ffosilva/bc-awake/openspec/changes/archive/2026-10-20-esp32cam-hardware-resilience-circuit/README.md

# esp32cam-hardware-resilience-circuit

Document and specify RC filtering and hardware resilience circuits for ESP32-CAM
