ffosilva/bc-awake/openspec/changes/esp32cam-prototype-pcb/README.md

# esp32cam-prototype-pcb

Create KiCad single-layer prototype carrier PCB for ESP32-CAM resilience circuit
