ffosilva/bc-awake/openspec/changes/archive/2026-10-10-captive-portal-inline-rename/README.md

# captive-portal-inline-rename

Replace window.prompt with inline row rename and formalize captive-portal UI resilience in setup-portal spec
