ffosilva/bc-awake/hardware/kicad/esp32cam-carrier/esp32cam-carrier.pdf

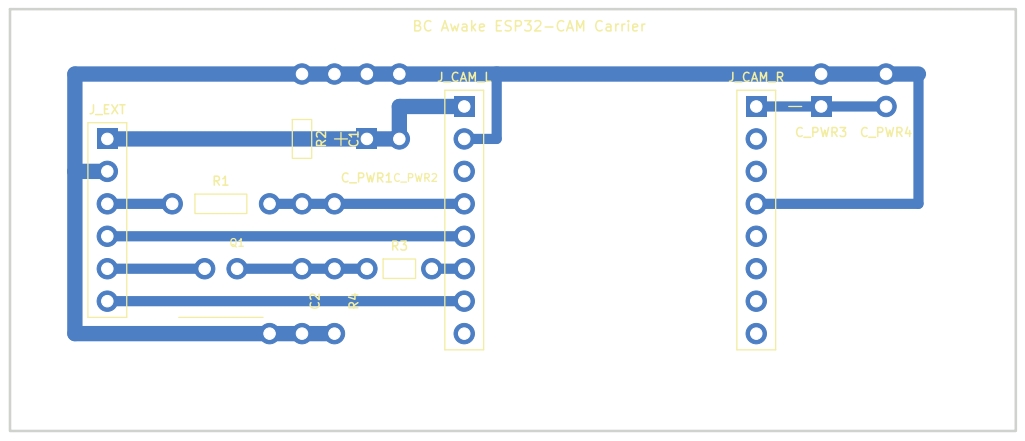
[picture p2: page 1]

BC Awake ESP32-CAM Carrier J_EXT
