ffosilva/bc-awake/hardware/kicad/esp32cam-carrier/esp32cam-carrier.kicad_pcb

## KiCad design hardware/kicad/esp32cam-carrier/esp32cam-carrier.kicad_pcb (2026-10-22)

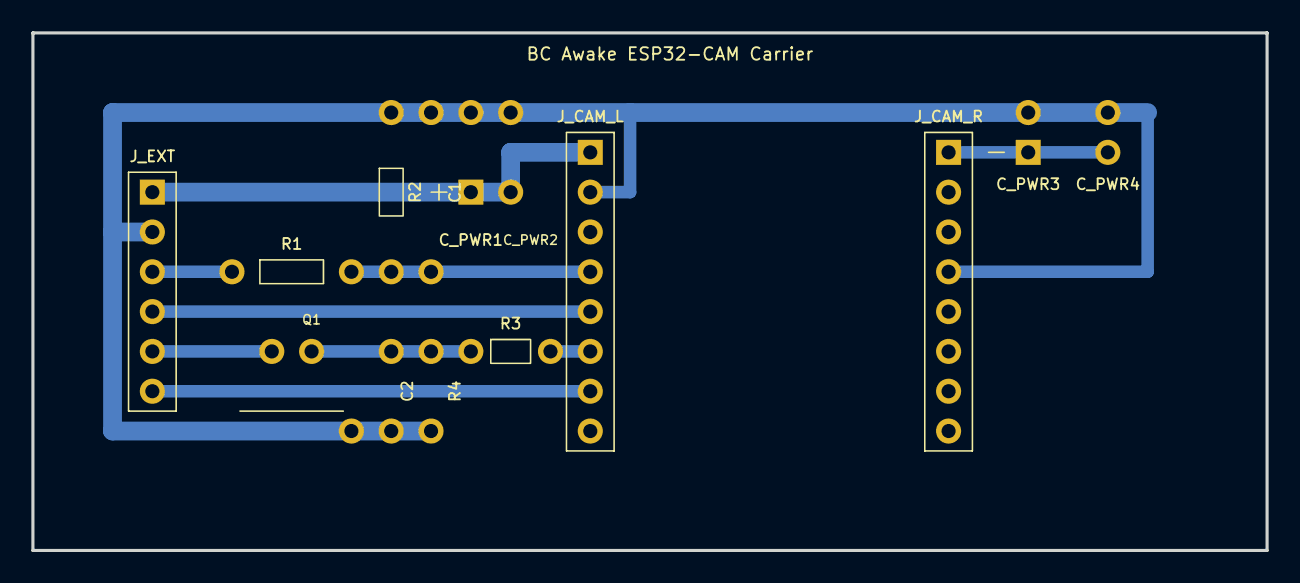
[picture p3: board esp32cam-carrier.kicad_pcb from above]

Board: 2 copper layers, 78.7 x 33.0 mm, 14 parts (0 on the bottom side), 10 nets.

Parts:
C1, C2: 100nF; C_Disc_D5.0mm_W2.5mm_P2.50mm
C_PWR1: 470uF; CP_Radial_D8.0mm_P3.50mm
C_PWR2, C_PWR4: 100nF; C_Disc_D5.0mm_W2.5mm_P2.50mm
C_PWR3: 47uF; CP_Radial_D6.3mm_P2.50mm
J_CAM_L: ESP32-CAM_L; PinSocket_1x08_P2.54mm_Vertical
J_CAM_R: ESP32-CAM_R; PinSocket_1x08_P2.54mm_Vertical
J_EXT: Ext_Terminals; PinHeader_1x06_P2.54mm_Vertical
Q1: BC547; TO-92_Inline
R1, R3: 1k; R_Axial_DIN0207_L6.3mm_D2.5mm_P7.62mm_Horizontal
R2: 4.7k; R_Axial_DIN0207_L6.3mm_D2.5mm_P7.62mm_Horizontal
R4: 100k; R_Axial_DIN0207_L6.3mm_D2.5mm_P7.62mm_Horizontal

Connections:
+3V3: C_PWR3.1, C_PWR4.1, J_CAM_R.1
+5VSB: C_PWR1.1, C_PWR2.1, J_CAM_L.1, J_EXT.1
BTN_A: J_CAM_L.5, J_EXT.4
GND: C1.1, C2.2, C_PWR1.2, C_PWR2.2, C_PWR3.2, C_PWR4.2, J_CAM_L.2, J_CAM_R.4, J_EXT.2, Q1.3, R2.1, R4.2
NET_GATE: C2.1, Q1.2, R3.1, R4.1
NET_IO13: C1.2, J_CAM_L.4, R1.2, R2.2
NET_IO14: J_CAM_L.6, R3.2
PS_ON#: J_EXT.5, Q1.1
PWR_BTN#: J_CAM_L.7, J_EXT.6
TPMS1: J_EXT.3, R1.1
