ffosilva/bc-awake/include/portal.h

#pragma once

#include <Arduino.h>
#include "board.h"

// Setup mode (SoftAP + discovery)
void portalBegin();
void portalLoop();
bool isPortalSetupMode();

// Normal mode persistent web server
void portalServerBegin();
void portalCheckRestart();

// Board state provider implemented by main.cpp
const char *getBoardStateName();

// Interactive pairing mode state
bool portalIsPairingActive();
void portalPairingStop();

// Wake cooldown arming implemented by main.cpp
void armWakeCooldown(unsigned long durationMs = WAKE_WAKE_COOLDOWN_MS);
