ffosilva/bc-awake/(commit log)

2026-10-10 fix(portal): replace window.prompt with inline controller rename editor
    Captive portal WebViews (such as Apple's CNA and Android's CaptivePortalLogin) suppress browser-native dialogs (window.prompt, window.alert), causing the controller rename button to silently do nothing when clicked.
    - Replace window.prompt with an inline row editor in app/index.html
    - Add keyboard support (Enter to save, Escape to cancel)
    - Display validation and network errors directly in the DOM
    - Formalize captive portal UI resilience in setup-portal spec
    - Archive OpenSpec change 2026-10-10-captive-portal-inline-rename
2026-10-13 feat(ota): add dual-bank ota update and firmware versioning
    - Reconfigure partition table with dual 1.81 MB OTA banks and 256 KB SPIFFS
    - Define compile-time semantic versioning and platform targets in include/version.h
    - Add authenticated POST /api/update streaming handler in setup portal with Update.h
    - Expose version and target in /api/status and display version badge in web UI
    - Add in-page firmware upload card to setup portal with progress bar
    - Update OpenSpec specifications and project documentation
    [partitions.csv]
2026-10-13 feat: add persistent setup portal, dynamic mac switching, and host sync
    Run the web server and REST API 24/7 over Wi-Fi Station with mDNS discovery, and dynamically switch Wi-Fi MAC between host dongle and ESP32 factory MAC across power states.
    - Enable persistent HTTP server on port 80 and mDNS advertising (bc250-switch.local) in normal Station mode
    - Implement dynamic Station MAC swapping: adopt host dongle MAC in STATE_OFF and revert to ESP32 factory MAC in STATE_BOOTING/STATE_ON
    - Add power-state aware API protections (403 on /api/network, 409 on /api/listener/start and /api/devices when powered on)
    - Expose boardState in /api/status and update web UI with status indicators and conditio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
    [main.cpp, network_wake.cpp, network_wake.h, portal.cpp, portal.h]
2026-10-13 feat: add configurable hostname and udp broadcast discovery
    Support custom device hostnames registered via DHCP and mDNS, and introduce an always-on UDP discovery responder on port 25025.
    - Add configurable hostname in NVS, DHCP (WiFi.setHostname), mDNS (MDNS.begin), REST API (/api/status, /api/network), and Web UI
    - Enforce RFC 1123 hostname validation (1–32 lowercase alphanumeric characters and hyphens)
    - Implement UDP broadcast discovery listener on port 25025 responding to BC250_DISCOVER with unicast JSON v1 across all power states
    - Add zero-config url=auto discovery mode to bc250-sync host tooling
    - Update OpenSpec specifications and archive configurable-hostname-and-discovery chang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
2026-10-13 feat(wake): inhibit power-on during controller pairing
    - Suppress controller and WOL wake triggers while pairing mode is active
    - Enforce 60s pairing timeout on firmware and add POST /api/listener/stop endpoint
    - Add non-blocking rapid flash LED burst (3 pulses) on ESP32-CAM upon listener start
    - Update setup portal UI with live 60s countdown, timeout screen, and post-save cooldown notice
    - Arm 15s wake cooldown upon saving controller to absorb residual paging
    - Update OpenSpec specifications and archive completed change
2026-10-14 feat(portal): add reset configuration action on system tab
    - Add Reset configuration card to System tab with in-page two-step confirmation
    - Implement resetConfig() to wipe NVS namespace and restore factory defaults
    - Add authenticated POST /api/reset endpoint with deferred restart into setup mode
    - Sync configuration-storage and setup-portal specs and archive OpenSpec change
    [config.cpp, config.h, portal.cpp]
2026-10-14 feat(power): add optional graceful shutdown power button mirroring
    - Route optional PWR_BTN_PIN on ESP32-CAM (GPIO2), DevKitC (GPIO27), and ESP32-C3 (GPIO7)
    - Mirror physical button to motherboard PWR_BTN# when running in STATE_ON
    - Add non-blocking 300 ms shutdown pulse via portal /api/shutdown endpoint
    - Add graceful shutdown setting persistence and toggle on portal System tab
    - Document pinouts, wiring diagrams, and UART flashing caveat on ESP32-CAM
    - Track planning and tasks in OpenSpec change add-graceful-shutdown-button
2026-10-14 feat(portal): restrict ota update to powered-off state
    Allow over-the-air firmware updates only when the BC250 host machine is turned off (STATE_OFF), preventing system disruption or state desync while the host is active.
    - Reject /api/update chunked uploads and response with HTTP 409 Conflict when host is powered on or booting
    - Disable OTA file selection and upload button in portal UI when host is on, displaying an explanatory notice
    - Re-enable file input when board transitions to STATE_OFF
    - Sync setup-portal specifications and archive change restrict-ota-to-powered-off
    [portal.cpp]
2026-10-14 feat(portal): add power control tab and api endpoints
    - Add dedicated Power tab to web UI with live status telemetry
    - Add ATX power supply controls for remote power-on and force power-off
    - Add in-page confirmation modal to protect against accidental force power cuts
    - Move optional motherboard power button controls into Power tab as "Shut Down OS"
    - Implement authenticated POST /api/power/on and POST /api/power/off endpoints
    - Service remote power requests via non-blocking flags in main loop
2026-10-15 fix(config): shorten graceful shutdown nvs key to fit 15-char limit
    - Shorten Preferences key from "gracefulShutdown" to "graceful" to adhere to ESP-IDF's 15-character NVS key length limit
    - Add NVS key length constraint to OpenSpec configuration
    - Sync main specs and archive add-graceful-shutdown-button change
    [config.cpp, config.h]
2026-10-15 fix(wake): enable ble multi-controller wake and dynamic runtime sync
    - Match incoming BLE advertisements against all enrolled controllers (up to 8)
    - Synchronize active wake filter in memory dynamically on controller add/remove
    - Add wakeUpdateControllers() to wake interface across Classic BT and BLE
    - Sync controller-wake spec and archive multi-controller-wake-parity change
    [portal.cpp, wake.h, wake_ble.cpp, wake_classic.cpp]
2026-10-15 feat(power): allow native power button to boot machine
    - Arm INPUT_PULLUP on PWR_BTN_PIN during STATE_OFF when motherboard power button is enabled
    - Short tap on native button in STATE_OFF powers on the machine via PS_ON#
    - Long hold >= 8s on native button enters setup portal; >= 5s while ON triggers force-off backstop
    - Keep PWR_BTN_PIN in high-Z INPUT mode when ON or booting, driving LOW only for external button mirroring or API pulse
    - Update portal UI description and documentation for bidirectional power button control
    - Sync power-control and setup-portal OpenSpec specifications and archive change
    [main.cpp, portal.cpp, portal.h]
2026-10-15 revert(power): remove native power button boot to prevent bus latch-up
    Revert commit d9a9cd5879ded9ba2e10dfd070361cf4be77e31b.
    When the BC250 motherboard is unpowered (STATE_OFF), PWR_BTN# does not present an open circuit; instead, internal protection diodes and motherboard circuitry pull the pin to ~0.3-0.6V (logic LOW). Configuring INPUT_PULLUP on PWR_BTN_PIN causes the firmware to detect a continuous button hold, blocking power-on and triggering a loop into WiFi setup mode.
    [main.cpp, portal.cpp, portal.h]
2026-10-16 feat: rebrand project to BC Awake
    - Add project brand assets (logo and icon) under assets/
    - Update Bluetooth broadcast name to BC Awake
    - Update default device hostname and mDNS address to bc-awake
    - Update web portal title and setup references
    - Update discovery packet device identifier and host sync tool fallback
    - Update OpenSpec specifications and documentation
2026-10-16 docs(readme): refresh intro with subtitle and BC250 use cases
    - Add subtitle under badges summarizing core capabilities
    - Highlight living room console and on-demand AI streaming use cases
    - Clarify BC250 lack of low-power sleep states and on-demand wake value
2026-10-16 fix(portal): defer web server start until wi-fi connects to prevent bootloop
    - Remove premature portalServerBegin() invocation from normalBegin()
    - Start web server in networkWakeLoop() upon Wi-Fi Station connection
    - Add defensive guard in portalServerBegin() against WIFI_OFF mode
    - Sync setup-portal main spec and archive fix-portal-server-bootloop change
    [main.cpp, network_wake.cpp, portal.cpp]
2026-10-16 feat(setup): enable direct wi-fi onboarding while host is powered on
    - Launch setup portal SoftAP automatically on unconfigured boot while keeping button and power control active
    - Restrict 8s button hold for setup portal to STATE_OFF to preserve 5s force shutdown safety
    - Allow /api/network updates and Web UI network editing while host is ON during setup mode
    - Add 20s Wi-Fi association timeout with SoftAP fallback retention
    - Add standalone onboarding wizard script tools/bc250-setup/bc250-setup.py and mock test suite
    - Update documentation and sync setup-portal specification
2026-10-16 fix(setup): record explicit provisioned state on setup exit to prevent softap loop
    - Persist 'provisioned' key in NVS when completing setup or leaving via 8s button hold
    - Update isConfigured() to honor explicit provisioning while preserving backward-compatible fallback
    - Clear provisioned flag on factory reset
    - Sync configuration-storage and setup-portal specifications and archive change
    [config.cpp, config.h, main.cpp, portal.cpp]
2026-10-17 fix(wake): stabilize bluetooth wake and remove esp32-cam flash led
    - Remove ESP32-CAM flash LED pulsing, NVS flashOnWake config, /api/settings route, and portal UI toggle while clamping GPIO 4 LOW at boot
    - Gate HCI OP_REMOTE_NAME_REQ in Classic BT behind active pairing listener to avoid radio burst during normal wake
    - Require 16 consecutive digital samples (SENSE_OVERSAMPLE) on ESP32-CAM BOARD_SENSE and increase STATE_BOOTING debounce to 250 ms
    - Sync specifications and archive stabilize-bt-wake-remove-cam-flash change
    [board.h, bt_classic.cpp, config.cpp, config.h, main.cpp, portal.cpp, portal.h]
2026-10-17 fix(power): prevent rapid on/off power flicker loop on esp32-cam
    - Pre-load PS_ON_PIN latch HIGH before enabling open-drain output
    - Space digital board-sense reads with 200us delay on ESP32-CAM
    - Require continuous 250ms board-sense HIGH before adopting STATE_ON and skip adoption on brownout reset
    - Make btBegin idempotent and restrict Bluetooth discovery and page scan to STATE_OFF
    - Cap ESP32-CAM Wi-Fi TX power to 11 dBm and defer station MAC swap by 500ms
    - Sync specifications and archive fix-state-on-power-flicker-loop change
    [board.h, bt_classic.cpp, main.cpp, network_wake.cpp, portal.cpp, wake_ble.cpp]
2026-10-17 fix(power): pre-load ps_on hardware latch and sync arduino hal after pinMode
    - Use gpio_set_level before pinMode(PS_ON_PIN, OUTPUT_OPEN_DRAIN) so the hardware latch is HIGH before enabling the pad driver
    - Call digitalWrite(PS_ON_PIN, PS_ON_RELEASE) after pinMode so Arduino-ESP32 v3.x periman does not reject the write and leave PS_ON# LOW in STATE_OFF
    - Sync power-control specification and archive fix-pson-gpio-latch-init change
    [main.cpp]
2026-10-17 fix(wifi): initialize STA mode before swapping MAC address on power transition
    Delegate applyStateMacChange() to networkWakeBegin() after disconnecting Wi-Fi. This ensures WiFi.mode(WIFI_STA) initializes the ESP-IDF Wi-Fi driver before esp_wifi_set_mac() is called, fixing error 12289 (ESP_ERR_WIFI_NOT_INIT) and eliminating duplicated connection logic.
    [network_wake.cpp]
2026-10-17 fix(wifi): defer MAC swap to STATE_ON and clamp pre-connection TX power
    Defer Wi-Fi Station MAC restoration until 5000 ms after transitioning into STATE_ON, keeping Wi-Fi completely untouched during STATE_BOOTING to avoid ATX PSU turn-on inrush. Cancel pending swaps on STATE_OFF. Clamp hardware PHY TX power via esp_wifi_set_max_tx_power() immediately after setting STA mode before WiFi.begin() starts RF transmission.
    [board.h, main.cpp, network_wake.cpp, network_wake.h]
2026-10-20 feat(lifecycle)!: isolate setup mode and disable radios while host is on
    Completely tear down Wi-Fi and Bluetooth controllers when the host enters STATE_BOOTING or STATE_ON, restoring them only in STATE_OFF to prevent radio interference and brownouts. Lock PS_ON# released during Setup Mode so the host motherboard cannot power on while configuring the device. Restrict the web portal and REST API exclusively to Setup Mode over SoftAP, running normal station Wi-Fi headless for Wake-on-LAN.
    BREAKING CHANGE: The web portal and REST API are offline during normal operation; host machine power-on is disabled during Setup Mode; remote power action endpoints (/api/power/on, /api/power/off, /api/shutd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
    [bt_classic.cpp, bt_classic.h, main.cpp, network_wake.cpp, network_wake.h, portal.cpp, portal.h]
2026-10-20 docs(hardware): specify esp32-cam resilience and anti-oscillation circuit
    Add schematics, BOM, and wiring guidelines for dual-rail power decoupling, GPIO 13 pull-down and low-pass filtering, and GPIO 14 MOSFET buffer isolation to prevent brownout reboot loops.
2026-10-20 feat(hardware): add ESP32-CAM single-layer prototype carrier PCB design
    - Add KiCad 8+ schematic and single-layer PCB layout for perfboard replication
    - Incorporate 2.54 mm pitch female sockets with 22.86 mm (0.9 in) spacing for ESP32-CAM
    - Integrate dual-rail bulk decoupling, TPMS1 RC filter, and 2N7000 MOSFET buffer
    - Add automated Python generator with DRC verification and SVG/PDF exports
    - Add assembly and soldering documentation in docs/esp32cam-carrier-pcb.md
    - Complete all tasks in OpenSpec esp32cam-prototype-pcb change
    [esp32cam-carrier.kicad_pcb, esp32cam-carrier.kicad_sch]
2026-10-20 feat(hardware): add AI-Thinker ESP32-CAM Bill of Materials and CSV export
    - Implement automated BOM CSV generation in scripts/generate_carrier_pcb.py
    - Export hardware/kicad/esp32cam-carrier/esp32cam-carrier-bom.csv with ratings and MPNs
    - Create comprehensive docs/bom.md for carrier passives, ATX wiring, and tools
    - Add BOM cross-references across README.md, pinout.md, and esp32cam-carrier-pcb.md
    - Sync AI-Thinker ESP32-CAM Bill of Materials requirement to hardware-targets spec
    - Archive OpenSpec change hardware-bom to archive/2026-10-20-hardware-bom
    [esp32cam-carrier-bom.csv, esp32cam-carrier.kicad_pcb, esp32cam-carrier.kicad_sch]
2026-10-20 fix(hardware): align ESP32-CAM carrier PCB and docs to physical pinout
    - Correct ESP32-CAM ASCII header diagrams in docs/pinout.md to match physical module
    - Realign J_CAM_L and J_CAM_R socket mappings and isolate IO16 (PSRAM) in scripts/generate_carrier_pcb.py
    - Re-route single-layer copper B.Cu with zero track crossings and 0 DRC violations
    - Update J_EXT terminal ordering and coordinate maps in docs/esp32cam-carrier-pcb.md and docs/bom.md
    - Sync hardware-targets spec and archive esp32cam-prototype-pcb and fix-esp32cam-carrier-pinout changes
    [esp32cam-carrier.kicad_pcb, esp32cam-carrier.kicad_sch]
2026-10-21 fix(hardware): isolate ESP32-CAM GND/R reset pin on carrier PCB
    Disconnect J_CAM_R pin 8 (GND/R) from ground to prevent holding the ESP32-CAM in hardware reset on clone boards, reroute the bottom ground bus via the left edge, and update documentation and specs.
    [esp32cam-carrier.kicad_pcb, esp32cam-carrier.kicad_sch]
2026-10-22 feat(power): invert PS_ON# logic for N-MOSFET buffer circuit
    fix(esp32cam): sample TPMS1 via ADC2 with carrier board hysteresis thresholds
    [board.h, main.cpp]
2026-10-22 feat(hardware): add esp32cam-carrier target and standardize bjt buffer
    - Add [env:esp32cam-carrier] build environment with BOARD_ESP32CAM_CARRIER macro
    - Standardize carrier PCB switch on BC547/BC548 NPN BJT (C-B-E pinout)
    - Drive active-HIGH push-pull PS_ON# and read ADC2 oversampled hysteresis on carrier board
    - Restore bare ESP32-CAM target to open-drain active-LOW and digital board sense
    - Regenerate KiCad schematics, PCB, netlist, DRC report, BOM, and documentation
    - Sync hardware-targets and power-control specs and archive change
    [esp32cam-carrier-bom.csv, esp32cam-carrier.kicad_pcb, esp32cam-carrier.kicad_sch]
2026-10-23 feat(esp32cam): add status LED on onboard red LED (GPIO33)
    Drive the onboard red LED on all ESP32-CAM builds: solid when ON, ~4 Hz blink while BOOTING, off when OFF, 1 Hz blink in setup mode (setup mode overrides power state). No-op on targets without a status LED.
    Includes docs, synced specs (status-led, hardware-targets) and the archived OpenSpec change.
